harrowm/Rosco-CoPro/README.md

# Rosco-CoPro
A 68882 floating point coprocessor board for the rosco_m68k SBC
