harrowm/Rosco-CoPro/Rosco-CoPro.kicad_pcb

## KiCad design Rosco-CoPro.kicad_pcb (2024-04-09)

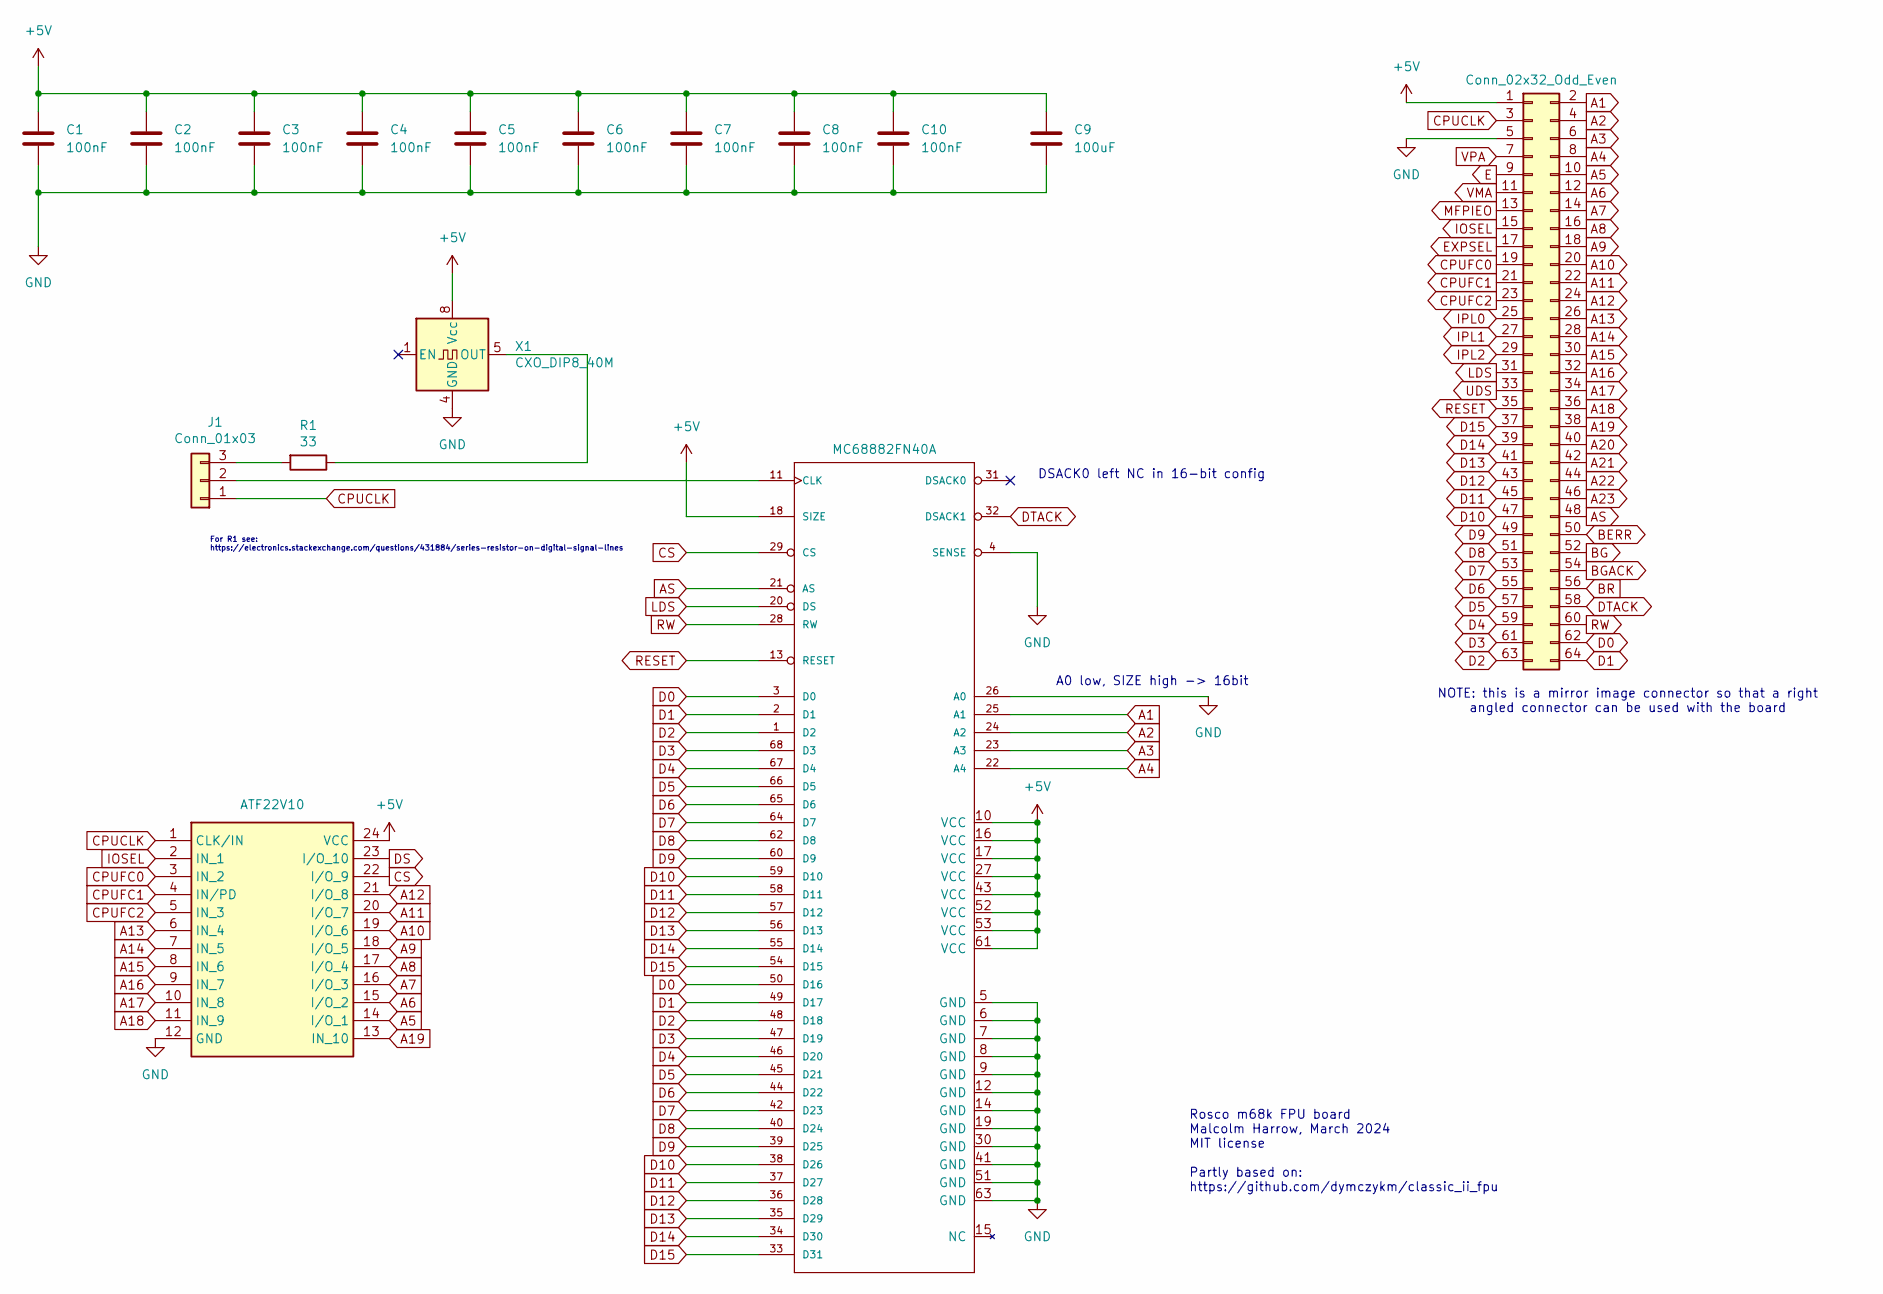
[picture p1: schematic Rosco-CoPro.kicad_sch]

Parts:
BUS1: Conn_02x32_Odd_Even; PinHeader_2x32_P2.54mm_Vertical
C1, C2, C3, C4, C5, C6, C7, C8, C10: 100nF; C_0805_2012Metric_Pad1.18x1.45mm_HandSolder; LCSC C49678
C9: 100uF; CP_Radial_D5.0mm_P2.50mm
IC1: MC68882FN40A; PLCC-68_THT-Socket
IC2: ATF22V10; DIP-24_W7.62mm_LongPads; Mouser Part Number 556-AF22V10C15PU
J1: Conn_01x03; PinHeader_1x03_P2.54mm_Vertical
R1: 33; R_0805_2012Metric_Pad1.20x1.40mm_HandSolder; LCSC C17634
X1: CXO_DIP8_40M; Oscillator_DIP-8_LargePads

Connections:
+5V: BUS1.1, C1.1, C2.1, C3.1, C4.1, C5.1, C6.1, C7.1, C8.1, C9.1, C10.1, IC1.10 (VCC), IC1.16 (VCC), IC1.17 (VCC), IC1.18 (SIZE), IC1.27 (VCC), IC1.43 (VCC), IC1.52 (VCC), IC1.53 (VCC), IC1.61 (VCC), IC2.24 (VCC), X1.8 (Vcc)
A1: BUS1.2, IC1.25 (A1)
A2: BUS1.4, IC1.24 (A2)
A3: BUS1.6, IC1.23 (A3)
A4: BUS1.8, IC1.22 (A4)
A5: BUS1.10, IC2.14 (I/O_1)
A6: BUS1.12, IC2.15 (I/O_2)
A7: BUS1.14, IC2.16 (I/O_3)
A8: BUS1.16, IC2.17 (I/O_4)
A9: BUS1.18, IC2.18 (I/O_5)
A10: BUS1.20, IC2.19 (I/O_6)
A11: BUS1.22, IC2.20 (I/O_7)
A12: BUS1.24, IC2.21 (I/O_8)
A13: BUS1.26, IC2.6 (IN_4)
A14: BUS1.28, IC2.7 (IN_5)
A15: BUS1.30, IC2.8 (IN_6)
A16: BUS1.32, IC2.9 (IN_7)
A17: BUS1.34, IC2.10 (IN_8)
A18: BUS1.36, IC2.11 (IN_9)
A19: BUS1.38, IC2.13 (IN_10)
A20: BUS1.40
A21: BUS1.42
A22: BUS1.44
A23: BUS1.46
AS: BUS1.48, IC1.21 (AS)
BERR: BUS1.50
BG: BUS1.52
BGACK: BUS1.54
BR: BUS1.56
CPUCLK: BUS1.3, IC2.1 (CLK/IN), J1.1
CPUFC0: BUS1.19, IC2.3 (IN_2)
CPUFC1: BUS1.21, IC2.4 (IN/PD)
CPUFC2: BUS1.23, IC2.5 (IN_3)
CS: IC1.29 (CS), IC2.22 (I/O_9)
D0: BUS1.62, IC1.3 (D0), IC1.50 (D16)
D1: BUS1.64, IC1.2 (D1), IC1.49 (D17)
D2: BUS1.63, IC1.1 (D2), IC1.48 (D18)
D3: BUS1.61, IC1.47 (D19), IC1.68 (D3)
D4: BUS1.59, IC1.46 (D20), IC1.67 (D4)
D5: BUS1.57, IC1.45 (D21), IC1.66 (D5)
D6: BUS1.55, IC1.44 (D22), IC1.65 (D6)
D7: BUS1.53, IC1.42 (D23), IC1.64 (D7)
D8: BUS1.51, IC1.40 (D24), IC1.62 (D8)
D9: BUS1.49, IC1.39 (D25), IC1.60 (D9)
D10: BUS1.47, IC1.38 (D26), IC1.59 (D10)
D11: BUS1.45, IC1.37 (D27), IC1.58 (D11)
D12: BUS1.43, IC1.36 (D28), IC1.57 (D12)
D13: BUS1.41, IC1.35 (D29), IC1.56 (D13)
D14: BUS1.39, IC1.34 (D30), IC1.55 (D14)
D15: BUS1.37, IC1.33 (D31), IC1.54 (D15)
DS: IC2.23 (I/O_10)
DTACK: BUS1.58, IC1.32 (DSACK1)
E: BUS1.9
EXPSEL: BUS1.17
GND: BUS1.5, C1.2, C2.2, C3.2, C4.2, C5.2, C6.2, C7.2, C8.2, C9.2, C10.2, IC1.4 (SENSE), IC1.5 (GND), IC1.6 (GND), IC1.7 (GND), IC1.8 (GND), IC1.9 (GND), IC1.12 (GND), IC1.14 (GND), IC1.19 (GND), IC1.26 (A0), IC1.30 (GND), IC1.41 (GND), IC1.51 (GND), IC1.63 (GND), IC2.12 (GND), X1.4 (GND)
IOSEL: BUS1.15, IC2.2 (IN_1)
IPL0: BUS1.25
IPL1: BUS1.27
IPL2: BUS1.29
LDS: BUS1.31, IC1.20 (DS)
MFPIEO: BUS1.13
unnamed: IC1.11 (CLK), J1.2
unnamed: J1.3, R1.2
unnamed: R1.1, X1.5 (OUT)
RESET: BUS1.35, IC1.13 (RESET)
RW: BUS1.60, IC1.28 (RW)
UDS: BUS1.33
VMA: BUS1.11
VPA: BUS1.7

Notes on the sheet:
Rosco m68k FPU board Malcolm Harrow, March 2024 MIT license Partly based on: https://github.com/dymczykm/classic_ii_fpu
A0 low, SIZE high -> 16bit
For R1 see: https://electronics.stackexchange.com/questions/431884/series-resistor-on-digital-signal-lines
DSACK0 left NC in 16-bit config
NOTE: this is a mirror image connector so that a right angled connector can be used with the board

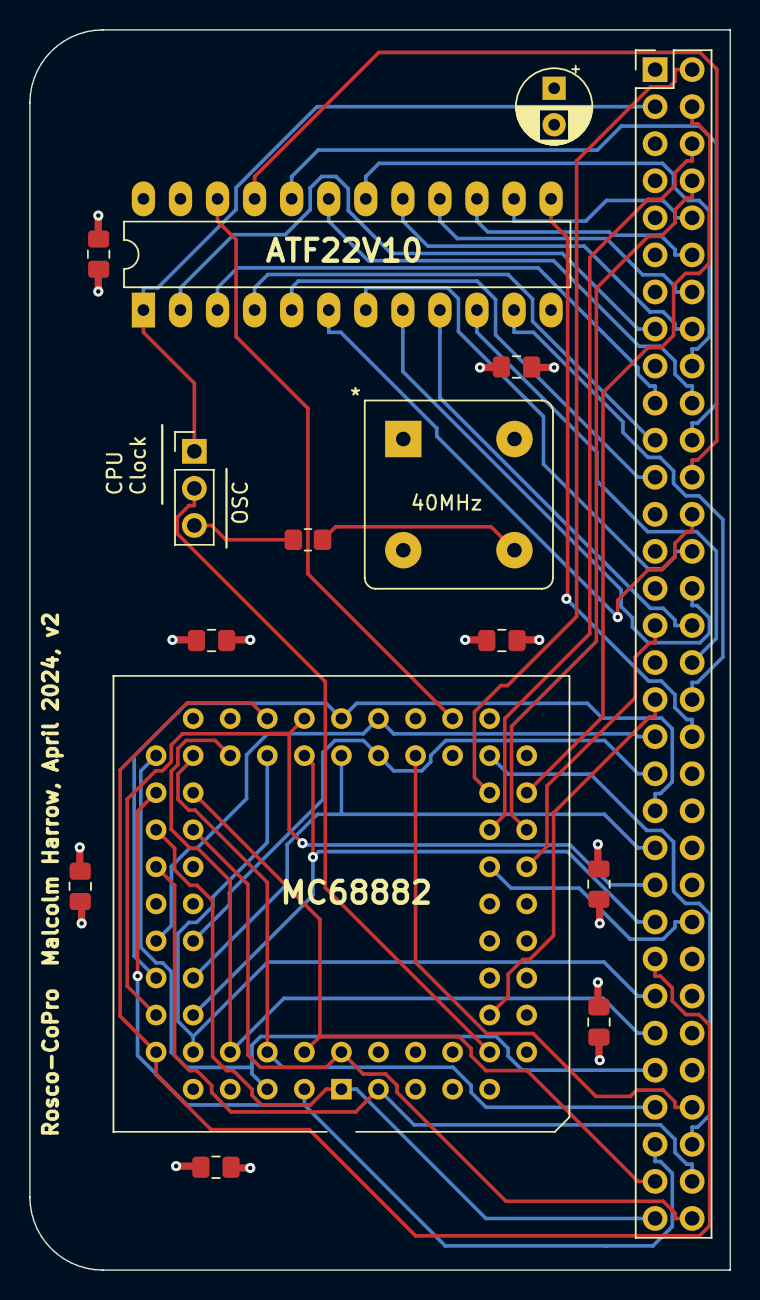
[picture p2: board Rosco-CoPro.kicad_pcb from above]

Board: 4 copper layers, 48.0 x 85.0 mm, 15 parts (0 on the bottom side), 51 nets.
