harrowm/Rosco-CoPro/(commit log)

2024-03-03 Added manufacturing files
    [Rosco-CoPro-CuBottom.gbr, Rosco-CoPro-CuIn1.gbr, Rosco-CoPro-CuIn2.gbr, Rosco-CoPro-CuTop.gbr, Rosco-CoPro-EdgeCuts.gbr, Rosco-CoPro-MaskBottom.gbr, Rosco-CoPro-MaskTop.gbr, Rosco-CoPro-NPTH.drl]
2024-03-10 Added in sample code
2024-04-09 v2 board plus improvements to test suite
    [Rosco-CoPro-B_Cu.gbl, Rosco-CoPro-B_Mask.gbs, Rosco-CoPro-B_Paste.gbp, Rosco-CoPro-B_Silkscreen.gbo, Rosco-CoPro-CuBottom.gbr, Rosco-CoPro-CuIn1.gbr, Rosco-CoPro-CuIn2.gbr, Rosco-CoPro-CuTop.gbr]
